lukezzh407-debug/Systolic-ai-accelerator/07_pnr_layout/README.md

# 07 — Place & route / layout

Placeholder. Floorplan, CTS, routing, and DRC/LVS notes plus **screenshots** will go here. GDS/OASIS, DEF, SPEF, and PDK views will not be published.
