lukezzh407-debug/Systolic-ai-accelerator/04_fpga/constraints/navigator.xdc

# Navigator constraints for Didactic SoC.

##############
# Timing
##############
## Global clk (50MHz)
create_clock -period 20.000 -name global_clk [get_ports clk_in]

create_clock -period 125.000 -name jtag_clk -waveform {0.000 62.500} -add [get_ports jtag_tck]
set_input_jitter jtag_clk 1.000

##################
# IO
###############
## CLK
set_property -dict {PACKAGE_PIN U18 IOSTANDARD LVCMOS33} [get_ports clk_in]

## RESET (Use PL_KEY0 for reset)
set_property -dict {PACKAGE_PIN L14 IOSTANDARD LVCMOS33} [get_ports reset]

## UART
set_property -dict {PACKAGE_PIN T19 IOSTANDARD LVCMOS33} [get_ports uart_rx]
set_property -dict {PACKAGE_PIN J15 IOSTANDARD LVCMOS33} [get_ports uart_tx]

## SPI (unused)
set_property -dict {PACKAGE_PIN F16 IOSTANDARD LVCMOS33} [get_ports {spi_data[0]}]
set_property -dict {PACKAGE_PIN M14 IOSTANDARD LVCMOS33} [get_ports {spi_data[1]}]
set_property -dict {PACKAGE_PIN G14 IOSTANDARD LVCMOS33} [get_ports {spi_data[2]}]
set_property -dict {PACKAGE_PIN N15 IOSTANDARD LVCMOS33} [get_ports {spi_data[3]}]
set_property -dict {PACKAGE_PIN W18 IOSTANDARD LVCMOS33} [get_ports {spi_csn[0]}]
set_property -dict {PACKAGE_PIN W19 IOSTANDARD LVCMOS33} [get_ports {spi_csn[1]}]
set_property -dict {PACKAGE_PIN R16 IOSTANDARD LVCMOS33} [get_ports spi_sck]

## GPIO (gpio[0-2] mapped to board LEDs for blink test)
set_property -dict {PACKAGE_PIN H15 IOSTANDARD LVCMOS33} [get_ports {gpio[0]}]
set_property -dict {PACKAGE_PIN L15 IOSTANDARD LVCMOS33} [get_ports {gpio[1]}]
set_property -dict {PACKAGE_PIN J16 IOSTANDARD LVCMOS33} [get_ports {gpio[2]}]

set_property -dict {PACKAGE_PIN R17 IOSTANDARD LVCMOS33} [get_ports {gpio[3]}]
set_property -dict {PACKAGE_PIN W20 IOSTANDARD LVCMOS33} [get_ports {gpio[4]}]
set_property -dict {PACKAGE_PIN V20 IOSTANDARD LVCMOS33} [get_ports {gpio[5]}]
set_property -dict {PACKAGE_PIN P18 IOSTANDARD LVCMOS33} [get_ports {gpio[6]}]
set_property -dict {PACKAGE_PIN N17 IOSTANDARD LVCMOS33} [get_ports {gpio[7]}]

set_property -dict {PACKAGE_PIN R18 IOSTANDARD LVCMOS33} [get_ports {gpio[8]}]
set_property -dict {PACKAGE_PIN Y18 IOSTANDARD LVCMOS33} [get_ports {gpio[9]}]
set_property -dict {PACKAGE_PIN Y19 IOSTANDARD LVCMOS33} [get_ports {gpio[10]}]
set_property -dict {PACKAGE_PIN P15 IOSTANDARD LVCMOS33} [get_ports {gpio[11]}]
set_property -dict {PACKAGE_PIN P16 IOSTANDARD LVCMOS33} [get_ports {gpio[12]}]
set_property -dict {PACKAGE_PIN V16 IOSTANDARD LVCMOS33} [get_ports {gpio[13]}]
set_property -dict {PACKAGE_PIN W16 IOSTANDARD LVCMOS33} [get_ports {gpio[14]}]
set_property -dict {PACKAGE_PIN T14 IOSTANDARD LVCMOS33} [get_ports {gpio[15]}]
