lukezzh407-debug/Systolic-ai-accelerator/05_asic_synth/rtl_baseline/subsystem.v

//-----------------------------------------------------------------------------
// File          : subsystem.v
// Creation date : 11.05.2026
// Creation time : 19:23:35
// Description   : 
// Created by    : genssler
// Tool : Kactus2 3.14.0 64-bit
// Plugin : Verilog generator 2.4
// This file was generated based on IP-XACT component tuni.fi:subsystem:subsystem:1.0
// whose XML file is /home/genp/work/msmcd-fe-lab/Didactic-SoC/ipxact/tuni.fi/subsystem/submodule/1.0/submodule.xml
//-----------------------------------------------------------------------------

module subsystem #(
    parameter                              NUM_GPIO         = 16,
    parameter                              APB_AW           = 16,
    parameter                              APB_DW           = 32
) (
    // Interface: APB
    input                [APB_AW-1:0]   PADDR,
    input                               PENABLE,
    input                               PSEL,
    input                [APB_DW-1:0]   PWDATA,
    input                               PWRITE,
    output               [APB_DW-1:0]   PRDATA,
    output                              PREADY,
    output                              PSLVERR,

    // Interface: Clock
    input                               clk,

    // Interface: IRQ
    output logic                        irq,

    // Interface: pmod_gpio
    input                [NUM_GPIO-1:0] pmod_gpi,
    output               [NUM_GPIO-1:0] pmod_gpio_oe,
    output               [NUM_GPIO-1:0] pmod_gpo,

    // These ports are not in any interface
    input                               irq_en,
    input                               reset_n
);

// WARNING: EVERYTHING ON AND ABOVE THIS LINE MAY BE OVERWRITTEN BY KACTUS2!!!

    assign irq = 0;
    assign pmod_gpio_oe = '0;
    assign pmod_gpo = '0;

    AI_ACC_TOP #(
                 .APB_AW(APB_AW),
                 .APB_DW(APB_DW),
                 .MATRIX_SIZE(32), 
                 .ARRAY_SIZE(4),
                 .MATRIX_DW(32),
                 .SUM_DW(32),
                 .MAC_LATENCY(16),
                 .RAM_READ_DELAY(1),
                 .MULT_MODE(0)
                ) u_AI_ACC_TOP (
                    .clk_in				 (clk),
                    .reset_int		 (reset_n),
                    .PADDR				 (PADDR),
                    .PENABLE			 (PENABLE),
                    .PSEL				   (PSEL),
                    .PWDATA				 (PWDATA),
                    .PWRITE				 (PWRITE),
                    .PSTRB				 (4'hF),
                    .PRDATA				 (PRDATA),
                    .PREADY				 (PREADY),
                    .PSLVERR			 (PSLVERR), 
                    .irq  				 (),
                    .irq_en 			 (irq_en),
                    .ss_ctrl  		 (),
                    .pmod_gpi			 (pmod_gpi),
                    .pmod_gpo			 (pmod_gpo),
                    .pmod_gpio_oe	 (pmod_gpio_oe)
                );

endmodule

module subsystem_tieoff #(
    parameter                              NUM_GPIO         = 16,
    parameter                              APB_AW           = 16,
    parameter                              APB_DW           = 32
) (
    // Interface: APB
    input                [APB_AW-1:0]   PADDR,
    input                               PENABLE,
    input                               PSEL,
    input                [APB_DW-1:0]   PWDATA,
    input                               PWRITE,
    output               [APB_DW-1:0]   PRDATA,
    output                              PREADY,
    output                              PSLVERR,

    // Interface: Clock
    input                               clk,

    // Interface: IRQ
    output logic                        irq,

    // Interface: pmod_gpio
    input                [NUM_GPIO-1:0] pmod_gpi,
    output               [NUM_GPIO-1:0] pmod_gpio_oe,
    output               [NUM_GPIO-1:0] pmod_gpo,

    // These ports are not in any interface
    input                               irq_en,
    input                               reset_n
);

// WARNING: EVERYTHING ON AND ABOVE THIS LINE MAY BE OVERWRITTEN BY KACTUS2!!!

    assign PRDATA = '0;
    assign PREADY = 1;
    assign PSLVERR = 0;
    assign irq = 0;
    assign pmod_gpio_oe = '0;
    assign pmod_gpo = '0;

endmodule
