lukezzh407-debug/Systolic-ai-accelerator/02_block_sim/uvm/ai_acc_tb_pkg.sv

`include "tb_defines.svh"

package ai_acc_tb_pkg;
  import uvm_pkg::*;
  `include "uvm_macros.svh"
  import ai_acc_sw_model::*;

  `include "apb_seq_item.svh"
  `include "apb_sequencer.svh"
  `include "apb_driver.svh"
  `include "apb_seq.svh"
  `include "apb_agent.svh"
  `include "ai_acc_env.svh"
  `include "ai_acc_base_test.svh"
  `include "ai_acc_smoke_test.svh"
  `include "ai_acc_matrix_mult_test.svh"
  `include "ai_acc_reg_test.svh"
endpackage
