lukezzh407-debug/Systolic-ai-accelerator/(commit log)

2026-09-18 Restructure the repo as a staged portfolio and publish the synthesis flow.
    Keep PDK/NDM/netlists out of git; add numbered placeholders for sim, SoC, FPGA, GLS, and PnR, and file both SRAM write-path RTL variants with their QoR reports.
2026-09-18 Add the no-cloning baseline RTL and its failing QoR reports.
    Point 01_rtl at this original unpacker-to-RAM write path and document why inferred flop SRAM creates the 65536 setup violations.
    [AI_ACC_TOP.sv, BUFFER_WRAPPER_SR.sv, DATA_UNPACKER.sv, MAC.sv, SA2APB_DATA_PROC.sv, SYSTOLIC_ARRAY.sv, SYSTOLIC_ARRAY_CONTROLLER.sv, sram.sv]
2026-10-25 Add short Edu4Chip SoC and FPGA integration notes.
    Show how the accelerator occupies one subsystem slot, and how the PYNQ-Z1 top wraps that SoC, without vendoring the Didactic sources.
